pacobaringo/limulusTag/hidrofono_pcb_v04/documentacion/gerber_bottom.png

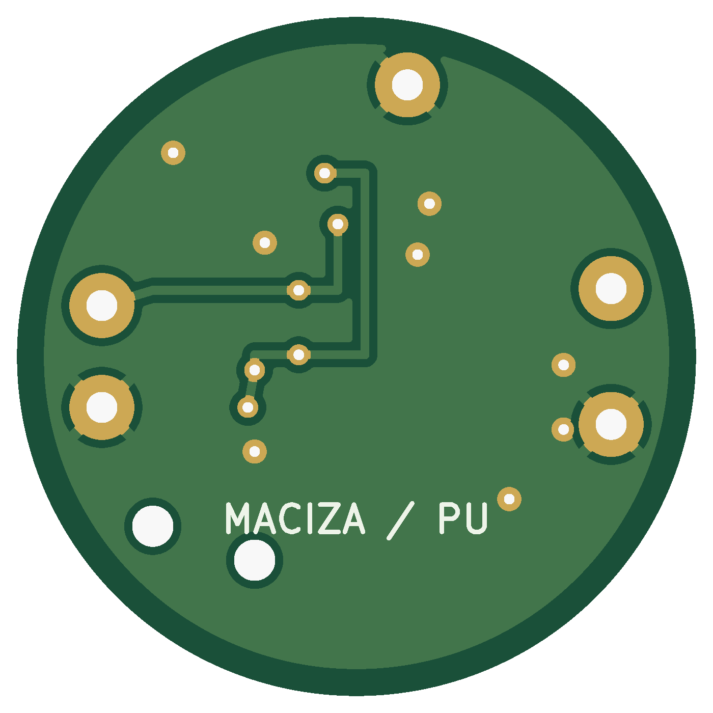
hidrofono_pcb_v04/documentacion/gerber_bottom.png
