pacobaringo/limulusTag/hidrofono_pcb_v04/documentacion/gerber_top.png

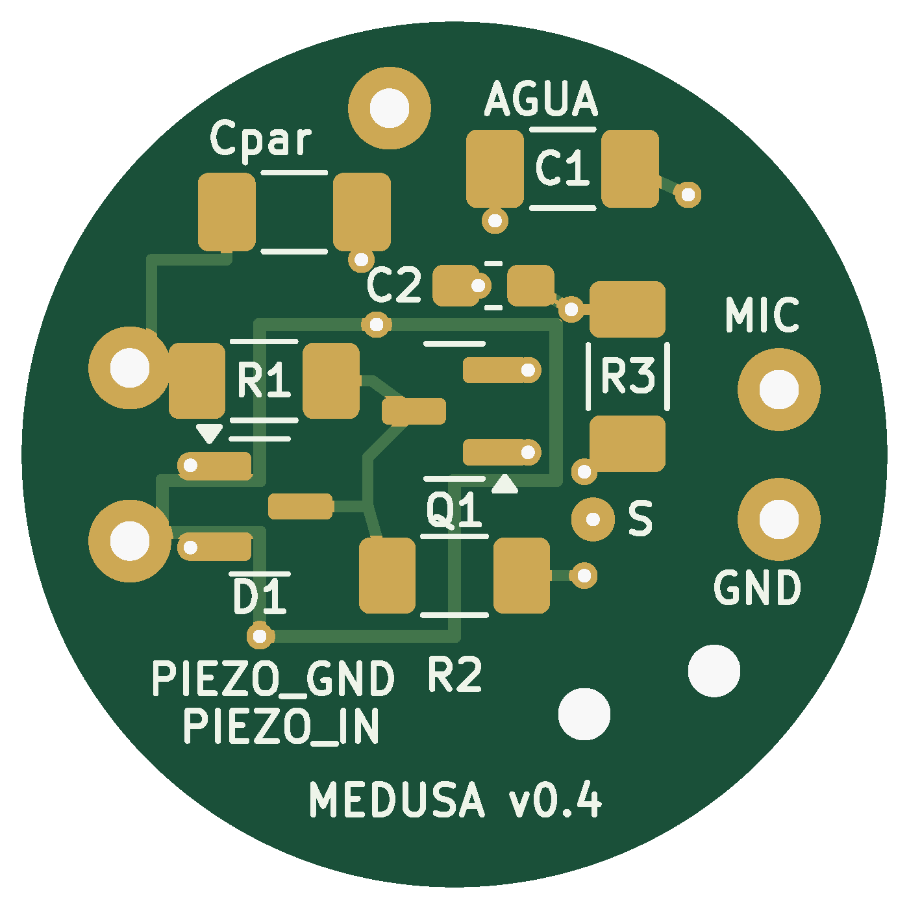
hidrofono_pcb_v04/documentacion/gerber_top.png
