pacobaringo/limulusTag/hidrofono_pcb_v04/documentacion/mapa_pads.csv

Pad | Red | X_mm | Y_mm
C1.1 | /SOURCE | 100.9375 | 93.4
C1.2 | /GND | 104.0625 | 93.4
C2.1 | /MIC | 100.0375 | 96.1
C2.2 | /GND | 101.7625 | 96.1
C3.1 | /PIEZO_IN | 94.7375 | 94.4
C3.2 | /GND | 97.8625 | 94.4
D1.1 | /GND | 94.5625 | 100.25
D1.2 | /GND | 94.5625 | 102.15
D1.3 | /GATE | 96.4375 | 101.2
J1.1 | /PIEZO_IN | 92.5 | 98.0
J1.2 | /GND | 92.5 | 102.0
J2.1 | /MIC | 107.5 | 98.5
J2.2 | /GND | 107.5 | 101.5
J3.1 | /GND | 98.5 | 92.0
Q1.1 | /SOURCE | 100.9375 | 99.95
Q1.2 | /MIC | 100.9375 | 98.05
Q1.3 | /GATE | 99.0625 | 99.0
R1.1 | /PIEZO_IN | 94.05 | 98.3
R1.2 | /GATE | 97.15 | 98.3
R2.1 | /GATE | 98.45 | 102.8
R2.2 | /GND | 101.55 | 102.8
R3.1 | /SOURCE | 104.0 | 99.75
R3.2 | /GND | 104.0 | 96.65
TP1.1 | /SOURCE | 103.2 | 101.5
