pacobaringo/limulusTag/hidrofono_pcb_v04/KiCad/hidrofono_v04.kicad_pcb

## KiCad design hidrofono_pcb_v04/KiCad/hidrofono_v04.kicad_pcb (2026-10-11)

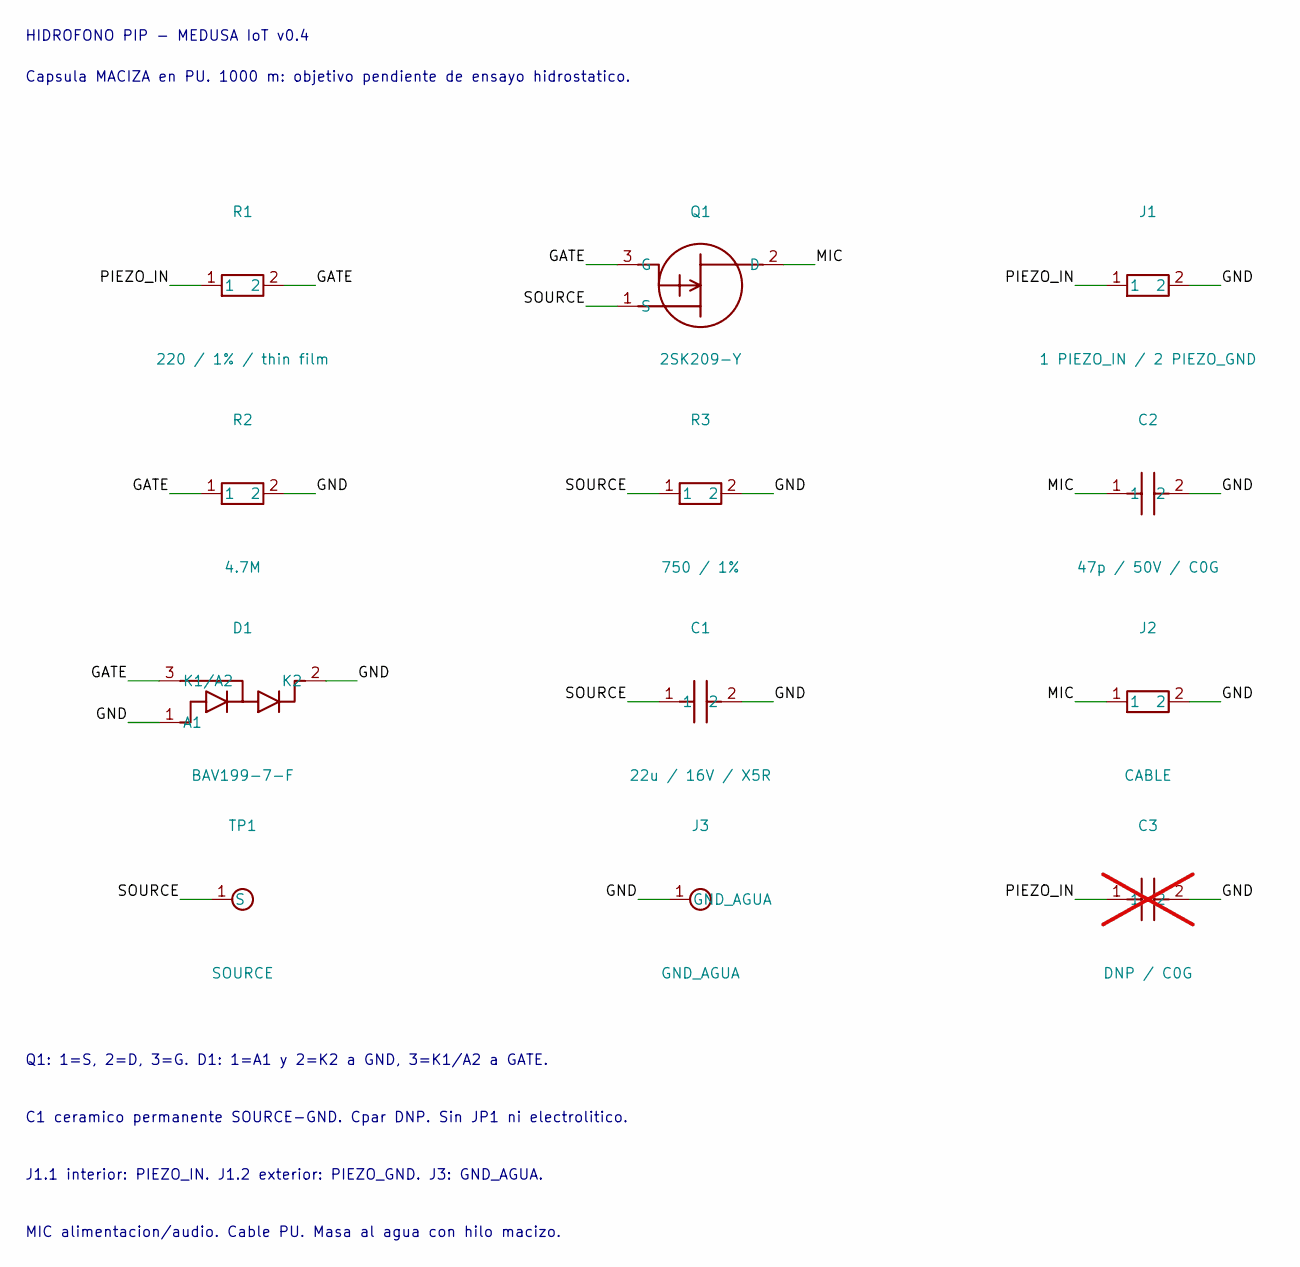
[picture p5: schematic hidrofono_v04.kicad_sch, Hidrofono PIP]

Parts:
C1: 22u / 16V / X5R; C1; MPN C3216X5R1C226M160AB
C2: 47p / 50V / C0G; C2; MPN C0603C470J5GACTU
C3: DNP / C0G; C3; MPN Por seleccionar tras ensayo; not fitted
D1: BAV199-7-F; D1; MPN BAV199-7-F
J1: 1 PIEZO_IN / 2 PIEZO_GND; J1
J2: CABLE; J2
J3: GND_AGUA; J3
Q1: 2SK209-Y; Q1; MPN 2SK209-Y(TE85L,F)
R1: 220 / 1% / thin film; R1; MPN RT1206FRE07220RL
R2: 4.7M; R2; MPN RC1206FR-074M7L
R3: 750 / 1%; R3; MPN RC1206FR-07750RL
TP1: SOURCE; TP1

Connections:
/GATE: D1.3 (K1/A2), Q1.3 (G), R1.2, R2.1
/GND: C1.2, C2.2, C3.2, D1.1 (A1), D1.2 (K2), J1.2, J2.2, J3.1, R2.2, R3.2
/MIC: C2.1, J2.1, Q1.2 (D)
/PIEZO_IN: C3.1, J1.1, R1.1
/SOURCE: C1.1, Q1.1 (S), R3.1, TP1.1

Notes on the sheet:
HIDROFONO PIP - MEDUSA IoT v0.4
Capsula MACIZA en PU. 1000 m: objetivo pendiente de ensayo hidrostatico.
Q1: 1=S, 2=D, 3=G. D1: 1=A1 y 2=K2 a GND, 3=K1/A2 a GATE.
C1 ceramico permanente SOURCE-GND. Cpar DNP. Sin JP1 ni electrolitico.
J1.1 interior: PIEZO_IN. J1.2 exterior: PIEZO_GND. J3: GND_AGUA.
MIC alimentacion/audio. Cable PU. Masa al agua con hilo macizo.

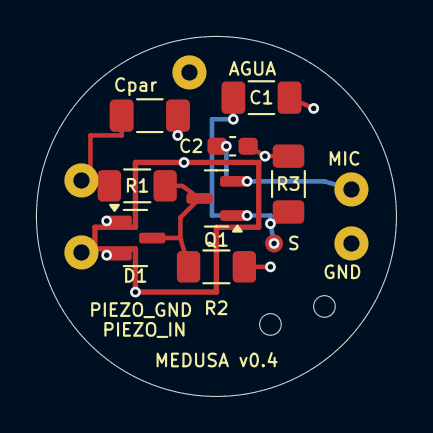
[picture p6: board hidrofono_v04.kicad_pcb from above]

Board: 2 copper layers, 20.0 x 20.0 mm, 14 parts (0 on the bottom side), 5 nets.

Other parts of the board:
H1: strain relief; H1
H2: strain relief; H2
